LionelBirglen/DataLogger/Schema.pdf

## Sensor board

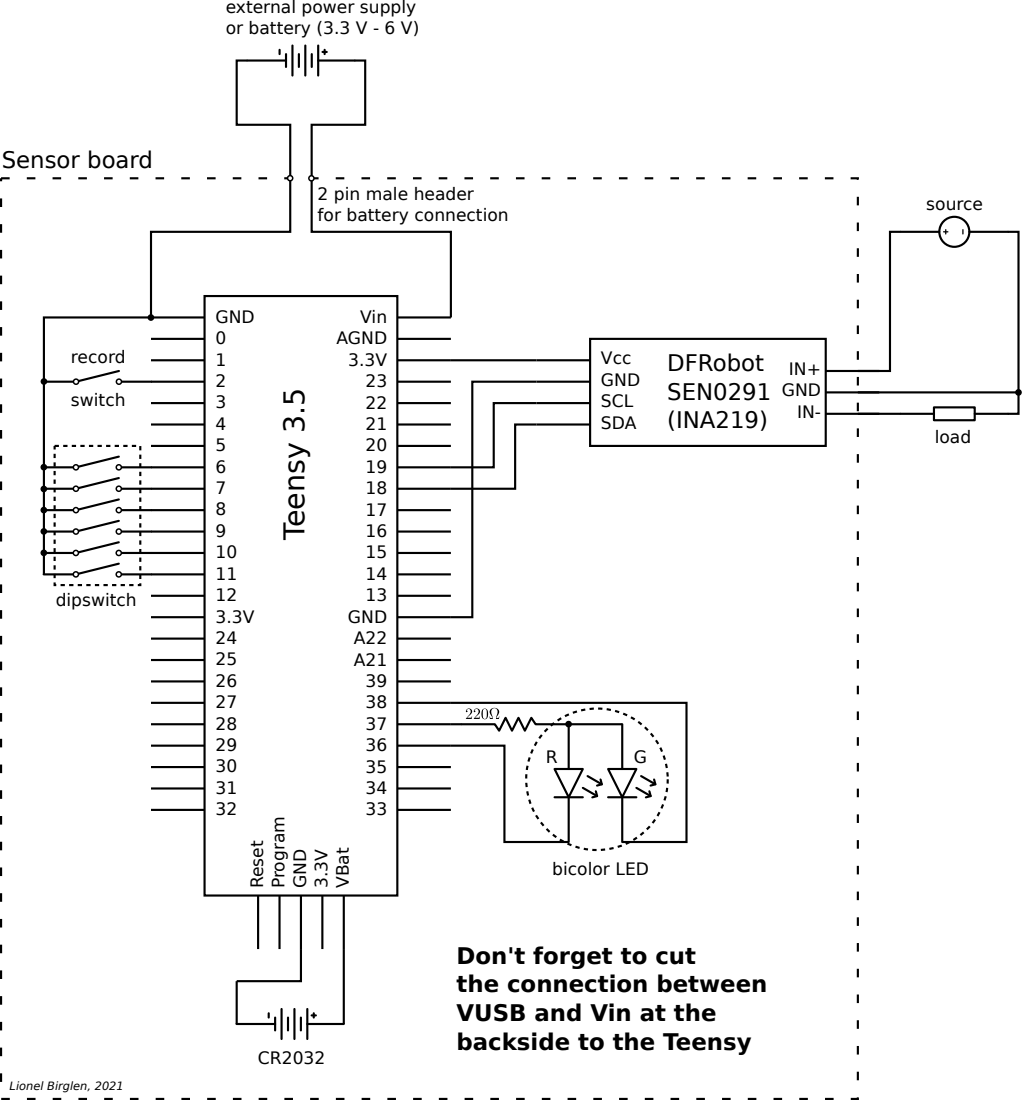
[picture p2: page 1]
GND 0 1 2 3 4 5 6 7 8 9 10 11 12 3.3V 24 25 26 27 28 29 30 31 32; Vcc GND SCL SDA; IN+ GND IN-; Vin AGND 3.3V 23 22 21 20 19 18 17 16 15 14 13 GND A22 A21 39 38 37 36 35 34 33; Teensy 3.5; DFRobot SEN0291 (INA219); Reset; Program; GND; VBat; Lionel Birglen, 2021; bicolor LED; dipswitch; record; switch; load; source

external power supply
or battery (3.3 V - 6 V)

2 pin male header
for battery connection

Don't forget to cut
the connection between
VUSB and Vin at the
backside to the Teensy
